ChrisChan114514/NUEDCTraining-2020E-DistortionWaveform-THDmeasure/2020年参考方案.pdf

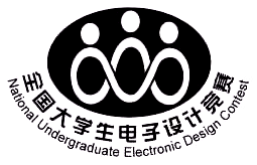
[picture p3: figure]

# 2020 年“TI 杯”第八届浙江省

# 大学生电子设计竞赛

# 设计报告

竞赛题号： | E

## 竞赛题目： 放大器非线性失真研究装置

参赛学生： | 钟沁轩 顾程鑫 李伟
参赛学校： | 杭州电子科技大学

2020 年 10 月

摘要

本作品完成了一个可以产生失真波形的放大器非线性失真研究装置，同时具

有测定波形谐波电压值与近似总失真系数的功能。作品以 STM32 单片机和 FPGA

为主控制器，STM32 控制 AD9959 DDS 模块，产生频率 1KHz、峰峰值 20mV 稳

定正弦波，并控制一个多路继电器，使三极管放大电路输出五种失真波形。波形

先经过以 OPA188 为主的信号调理电路，由 STM32 控制模块进行信号跟随或信

号放大。再送入 ADS8505 模块对信号进行模数转换。FPGA 先对采样倒的波形

数据缓存，再通过并行传输送入 STM32。STM32 对接受到的波形数据进行 FFT，

获得信号频谱数据，读取各个谐波分量电压值并进行总谐波失真系数计算。最后

将各个谐波分量电压值、总谐波失真系数、电压波形与数字频谱图进行屏幕打印。

关键词：放大器非线性失真分析；幅频特性；FFT；FPGA

1

## 一、方案比较（论证）

1、采集测量与微处理器方案比较与论证

方案一：使用 STM32F407 内置 ADC 采集晶体管放大器输出信号，并选择

STM32F407 作为微处理器，进行 FFT 处理获取谐波分量。这种方案的优点是系

统构成简单，所需硬件资源较少，但 STM32F407 的内置 ADC 只能测量 0V~3.3V

的输入电压，并且只有 12 位精度，无法保证精确测量，对信号 FFT 处理的影响

较大。同时，FFT 要求采样频率为 2 的指数，STM32 无法保证稳定精确的采样

频率，这也会影响 FFT 的结果，最终影响总谐波失真的准确测量。

方案二：通过 ADS8505 采集晶体管放大器输出信号，并使用 FPGA 缓存数

据。STM32 与 FPGA 进行并行传输获取缓存数据，计算 FFT 获取谐波分量。

ADS8505 的电压测量范围为-10V~+10V，具有 250KHz 采样率，精度高达 16 位。

通过 FPGA 设置精确时钟，可保证采样频率。同时，FPGA 与 STM32 的并行传

输，确保数据快速准确传输至 STM32F407 并进行 FFT 处理。此方案可以提高输

入电压范围，大大提高输入信号 FFT 的精确度。

综上所述，本系统采用方案二。
2、共射放大器级联方案比较与论证

方案一：采用单级共射放大器。根据理论计算及仿真分析，若采用 S9013H 三

极管，负载为100KΩ时的电压增益约为120V/V，可满足题目对于增益的要求，

但因无法使三极管同时工作在饱和区、截止区而产生双向失真，并且在后级功率

放大器产生交越失真时，由于增益过低也无法满足题目的输出幅值要求。

方案二：采用两级共射放大器级联。若采用两级阻容耦合共射放大器，可通

过控制第一级放大器增益产生一个大信号使第二级三极管产生双向失真，也可以

轻松控制整个放大器的电压增益，使输出幅值达到题目要求。

综上所述，本系统采用方案二。
3、AB 类功率放大器克服交越失真方案比较与论证

方案一：使用电阻压降产生偏置电压，使功率放大管处于微导通的状态，可

以有效的克服交越失真，虽然电路简单，但是电阻压降产生的偏置电压不稳定可

能会造成功率放大器的总谐波失真变大。

2

方案二：使用Vbe扩大电路产生偏置电压。Vbe扩大电路可以通过改变偏置电

阻的比值，从而改变功率放大管的偏压值，但电路结构较为复杂。

方案三：使用二极管压降产生偏置电压不但有着和电阻压降偏置同样简单的

电路，而且偏置电压较为稳定，且由于二极管的正向导通特性，无需复杂的设计

即可产生足够的偏置电压。

综上所述，本系统采用方案三。
4、ADC 信号调理方案比较与论证

方案一：仅使用运放跟随器。使用一颗精密运放进行跟随可以实现阻抗变换，

减小后级对前级电路的影响，但是测量20mVpp的输入信号时，由于信号幅值过于

微小，ADS8505 无法准确转换。

方案二：使用程控增益放大器。程控增益放大器可以轻松改变放大器增益，

但电路较为复杂且多数为高频电路设计，低频性能不佳，若要用于本题则需要重

新计算有关参数。

方案三：使用继电器切换同相放大器。使用继电器切换由运放组成的同相放

大电路，不仅可以实现阻抗变换的功能，而且可以在测量微小信号时使其放大一

定倍数，使 ADS8505 能够准确转换。

综上所述，本系统采用方案三。

## 二、理论分析与计算

1．共射放大电路静态工作点估算及交流电压放大倍数

共射放大电路如图 1 所示。在确定该电路静态工作点时，为保证 Q 点的稳

定，估算时选取：静态时
Rb2

流过的电流Ib = (5~10)IBQ,VBQ = (5~10)UBEQ。

计算公式如下：

VBQ ≈

Rb2

Rb1+Rb2

VCC | (1)

ICQ ≈

VBQ−UBEQ
Re

(2)

UCEQ = VCC − ICQ(RC + Re) | (3)

放大器交流放大倍数：

3

AV = −

β(RL//RC)

rbe

(4)

其中，
be r

为三极管输入电阻。其值为rbe = rbb′ + (1 + β)

UQ

IEQ

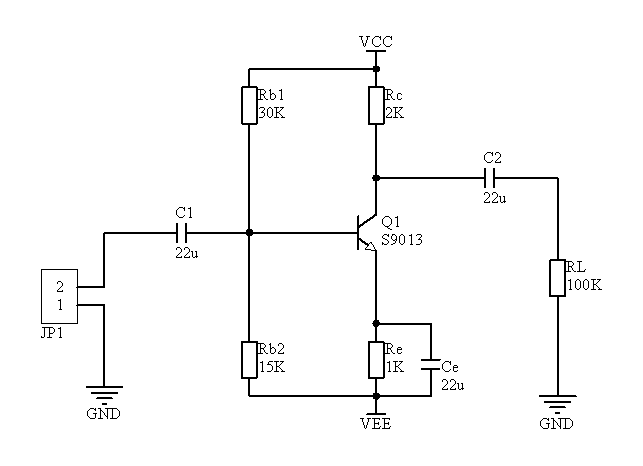
[picture p4: figure]

图 1 分压偏置式共射放大电路

其中，VCC=5V，VEE=-5V，β取 200，ICQ取 1.8mA，UBEQ取 0.64V，则VBQ=-

2.5V，IBQ=8.85μA，令Rb2=15KΩ，则Rb1≈43KΩ；令Re=1KΩ，则Rc ≈ 2KΩ。计

算Av ≈ 129V/V。实验发现有轻微削顶失真，故减小 Rb1 至30KΩ。 2．失真波形理论分析

1）顶部失真：三极管静态工作点过高，静态工作电流过小，管子进入截止区，

产生截止失真。

2）底部失真：三极管静态工作点过低，静态工作电流过大，管子进入饱和区，

产生饱和失真。

3）双向失真：放大器的输入信号幅值过高，导致信号正半周时管子进入截止

区，产生截止失真；信号负半周时管子进入饱和区，产生饱和失真，这两种失真

叠加就产生了双向失真。

4）交越失真：推挽式输出通常使用 NPN 型管和 PNP 型管，两管的基级和

发射极相互连接在一起，连接负载电阻。当有信号输入时，两个管子轮流导通。

若输入信号低于两管导通电压，两管都截止，负载上无电流通过，因此出现一段

死区，即交越失真。

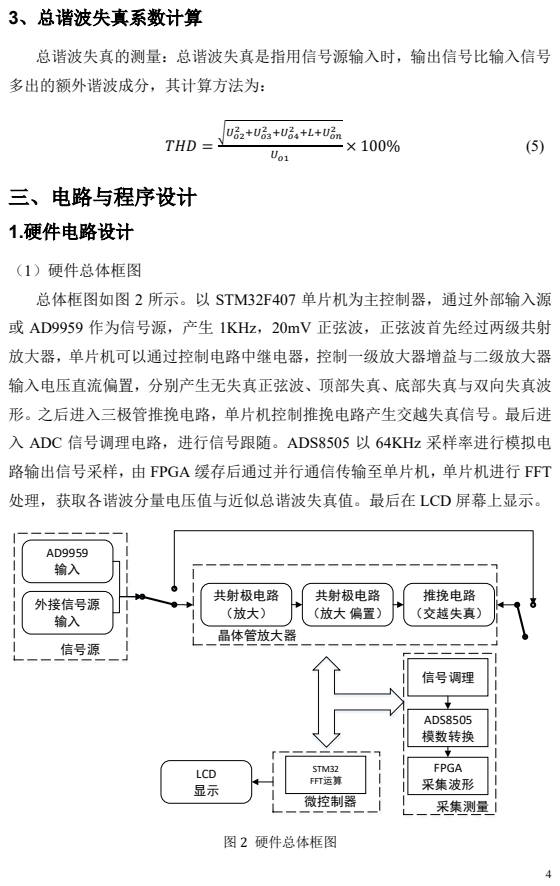
[picture p5: page 6]
3、总谐波失真系数计算; THD =; 2 +L+Uon; 三、电路与程序设计; 1.硬件电路设计; 信号调理; ADS8505 模数转换; STM32 FFT运算; 外接信号源 输入; LCD 显示; FPGA 采集波形; 微控制器; 采集测量; 信号源; 推挽电路 （交越失真）; 共射极电路 （放大 偏置）; 共射极电路 （放大）; 晶体管放大器; 图 2 硬件总体框图

总谐波失真的测量：总谐波失真是指用信号源输入时，输出信号比输入信号
多出的额外谐波成分，其计算方法为：

（1）硬件总体框图
总体框图如图 2 所示。以 STM32F407 单片机为主控制器，通过外部输入源
或 AD9959 作为信号源，产生 1KHz，20mV 正弦波，正弦波首先经过两级共射
放大器，单片机可以通过控制电路中继电器，控制一级放大器增益与二级放大器
输入电压直流偏置，分别产生无失真正弦波、顶部失真、底部失真与双向失真波
形。之后进入三极管推挽电路，单片机控制推挽电路产生交越失真信号。最后进
入 ADC 信号调理电路，进行信号跟随。ADS8505 以 64KHz 采样率进行模拟电
路输出信号采样，由 FPGA 缓存后通过并行通信传输至单片机，单片机进行 FFT
处理，获取各谐波分量电压值与近似总谐波失真值。最后在 LCD 屏幕上显示。

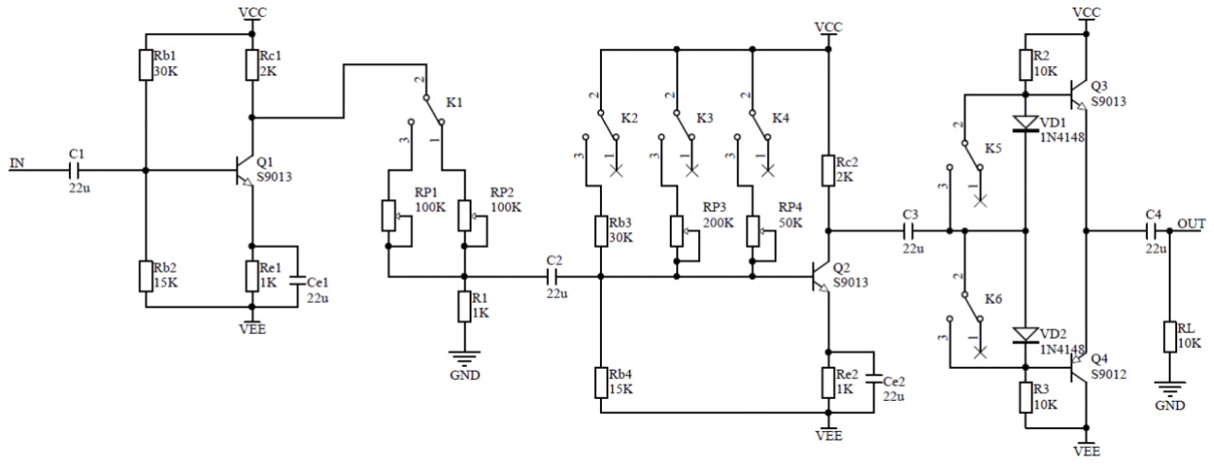
[picture p6: figure]

5

（2）程控放大器电路

本电路由两级三极管共射放大器和一级 AB 类三极管功率放大器组成，通过

继电器切换电阻和短路偏置二极管的方式，实现了程控产生四种失真波形的功能。

（如图 3 所示）

1）正常情况：继电器 K1，K3 吸合，其余继电器释放，Rp1 分压减小第二级

输入幅值，第二级放大不会发生失真，基极偏置电阻 Rb1，Rb2，Rb3，Rb4 为两

个晶体管提供正常偏置，后级功放管也处于微导通状态，无交越失真，电路正常

工作。

2)顶部失真：继电器 K2，K4 吸合，其余继电器释放， Rp2 阻值较小，使输

入第二级共射放大器的信号幅值增大，同时 Rp3 调整至比 Rb4 大的某一阻值，

使第二级放大器工作在截止区，波形出现顶部失真。

3)底部失真：继电器 K1，K5 吸合，其余继电器释放，其中 Rp4 调整至比 Rb4

小的某一阻值，使第二级放大器工作在饱和区，波形出现底部失真。

4)双向失真：继电器 K2，K3 吸合，其余继电器释放，其中 Rp2 调整成较小

阻值，使输入第二级共射放大器的信号幅值增大，使第二级放大器工作在饱和区，

截止区而产生双向失真。

5)交越失真：继电器 K1，K6，K7 吸合，其余继电器释放，前两级共射放大

器正常工作，末级功放由于二极管被短路，功放管失去直流偏置，信号低于管子

导通电压时管子无法导通，产生交越失真。

图 3 程控放大器电路原理图

6

(3)电源方案设计

系统电源方案分为模拟电源与数字电源两部分，模拟电源采用线性稳压器

78XX、79XX 系列，为系统内放大器电路与信号调理电路供电。数字电源采用开

关电源 TPS5430 系列，为系统内 STM32 与 FPGA 供电。
2.程序设计

STM32 控制 ADS9959 输出 1KHZ、20mVpp 的正弦波作为输入信号；FPGA

控制 ADS8505 以 64KSPS 速率采样，将得到的 ADC 数据存入内部的 RAM 中。

当 STM32 通过并口传输协议向 FPGA 发送数据请求时，FPGA 发送 ADC 采集到

256 个电压值发送给 STM32。STM32 根据得到的数据进行点数为 256 的 FFT 变

换，得到各个谐波分量的频谱信息，经过计算得到“总谐波失真”的近似值，最终

将得到的结果显示在 LCD 上。软件系统流程图如图 4 所示，“总谐波失真”的近

似值计算流程图如图 5 所示。

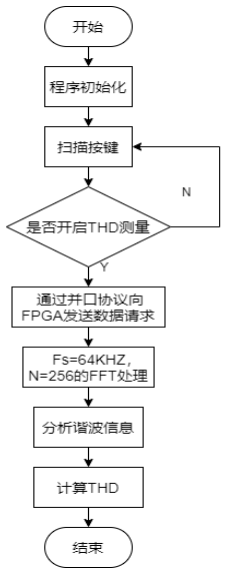
[picture p7: figure]
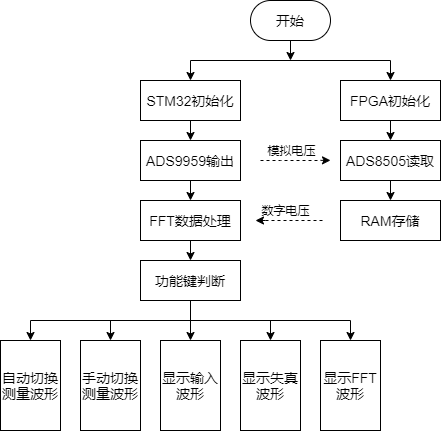
[picture p8: figure]

图 4 软件系统流程图 | 图 5 “总谐波失真”的近似值计算流程图

## 四、测试方案与测试结果

1、系统测试方案

采用外接信号源，通过硬件电路产生无失真或各种失真类型正弦波。用

7

ADS8505 采样输出电压，通过并行通信将数据传递至 STM32，STM32 进行 FFT

计算得到幅频特性曲线，并获取各谐波电压幅值，计算总谐波失真。

表 1 测试仪器列表

序号 | 仪器类别 | 仪器型号 | 数量 | 性能参数
1 | 信号源 | DG822 | 1 | 10HZ-35MHZ
2 | 示波器 | MSO5102 | 1 | 500Mhz
3 | 学生电源 | DP832 | 1 | 30V/3A*2
4 | 功率分析仪 | PA6000H | 1 | 可测量总谐波失真
2、测试结果与分析

（1）三极管放大器电路输出波形测试。

输入信号为 20mVpp，1KHz 正弦信号，测量输出电压波形，与电压波形幅值。

（无失真及各种失真波形图片见附录图片 6、7、8、9、10、11）

表 2 各失真波形峰峰值电压
波形种类 | 峰峰值电压
无明显失真电压波形 | 3.120V
顶部失真电压波形 | 4.736V
底部失真电压波形 | 2.908V
双向失真电压波形 | 6.232V
小交越失真电压波形 | 2.654V
大交越失真电压波形 | 2.512V
根据实验数据，放大器电路各类失真输出波形符合题目要求，输出电压峰峰

值都达到了 2V 以上，完全满足题目要求。
（2）采集测量模块 THD 误差测量。

输入信号为 20mVpp，1KHz 正弦信号，通过三极管放大电路输出各类失真波

形，与功率分析仪 PA6000H 测量 THD 值对照。结果如表 3 所示。

表 3 各失真波形 THD 值测试

输出波类型 | 功率分析仪 THD 值 | 实际测量 THD 值 | 误差
无明显失真正弦波 | 4.761% | 4.804% | 0.903%
顶部失真正弦波 | 60.941% | 61.325% | 0.630%

8

根据实验数据，采集测量模块测量 THD 值与实验仪器测量 THD 值误差保持

在 3%以内，有着比较高的采集测量精度。

## 五、总结

本作品设计了一个放大器非线性失真研究装置，实现了信号发生，波形放大、

程控输出多种失真波形与测量信号近似总谐波失真数值的功能。为了实现波形放

大与输出 5 种失真波形，必须准确计算放大电路电压增益与偏置电压，设计放大

器电路参数。与此同时，我们使用 FPGA 稳定的时钟晶振保证采样频率为 0.25kHz

的倍数，加快了采样速率，提高了 FFT 计算精度，保证了计算各谐波电压值的准

确性。

底部失真正弦波 | 14.751% | 14.702% | -0.332%
双向失真正弦波 | 24.785% | 25.187% | 1.621%
小交越失真正弦波 | 10.743% | 10.468% | -2.560%
大交越失真正弦波 | 22.536% | 22.500% | -0.160%
标准方波 | 38.889% | 39.050% | 0.414%
标准三角波 | 11.782% | 11．781% | -0.009%

9

附录

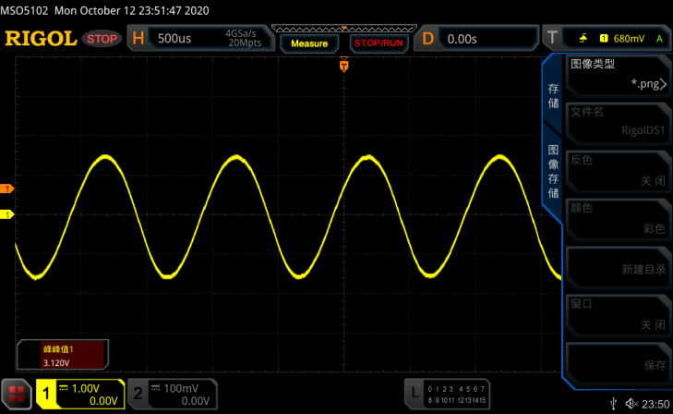
[picture p9: figure]

图 6 无失真正弦波

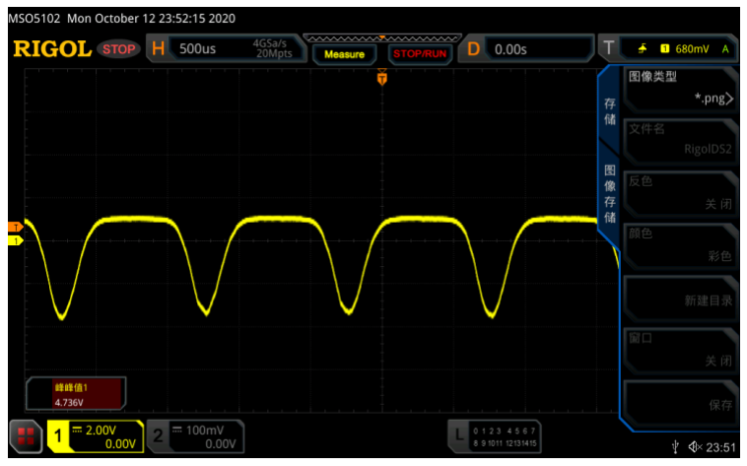
[picture p10: figure]

图 7 顶部失真

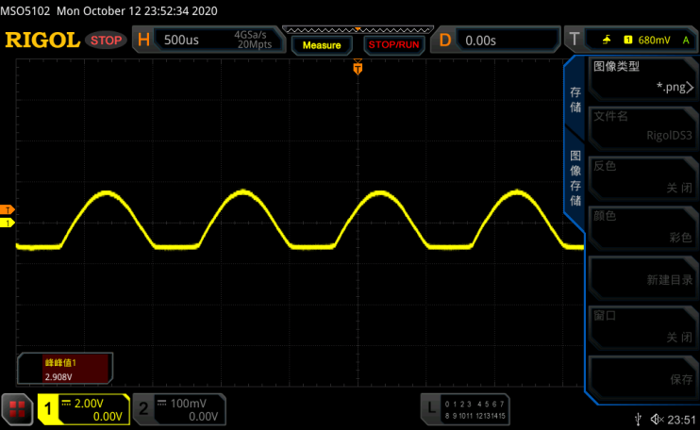
[picture p11: figure]

图 8 底部失真

10

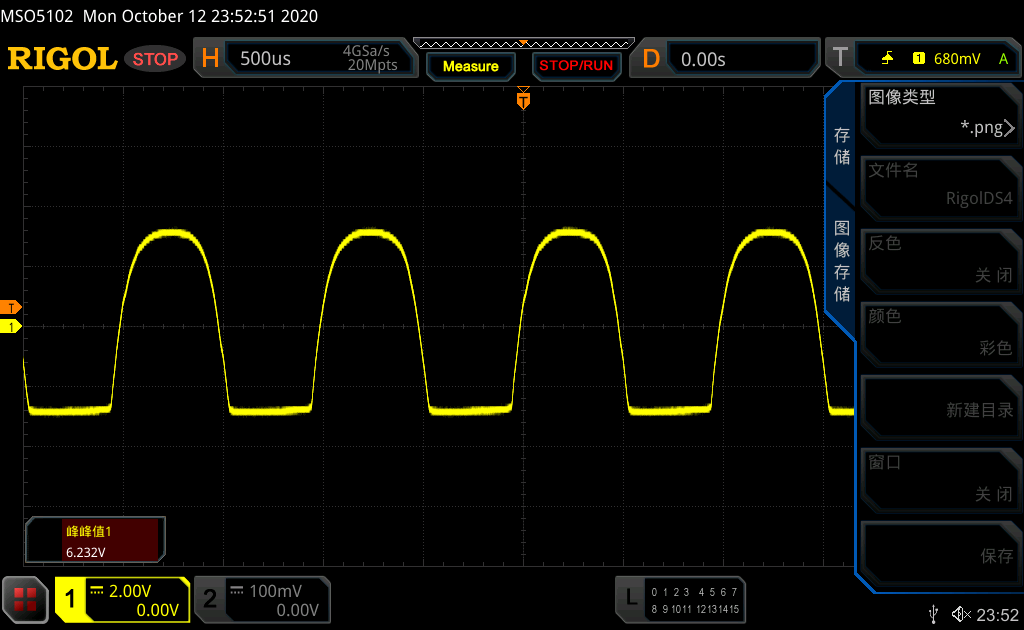
[picture p12: figure]

图 9 双向失真

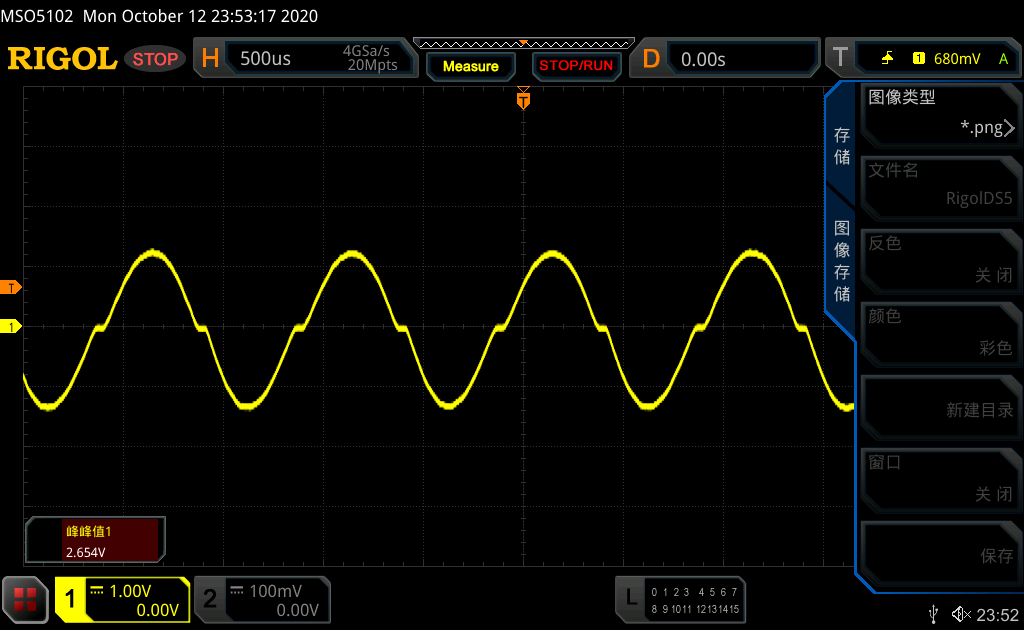
[picture p13: figure]

图 10 小交越失真

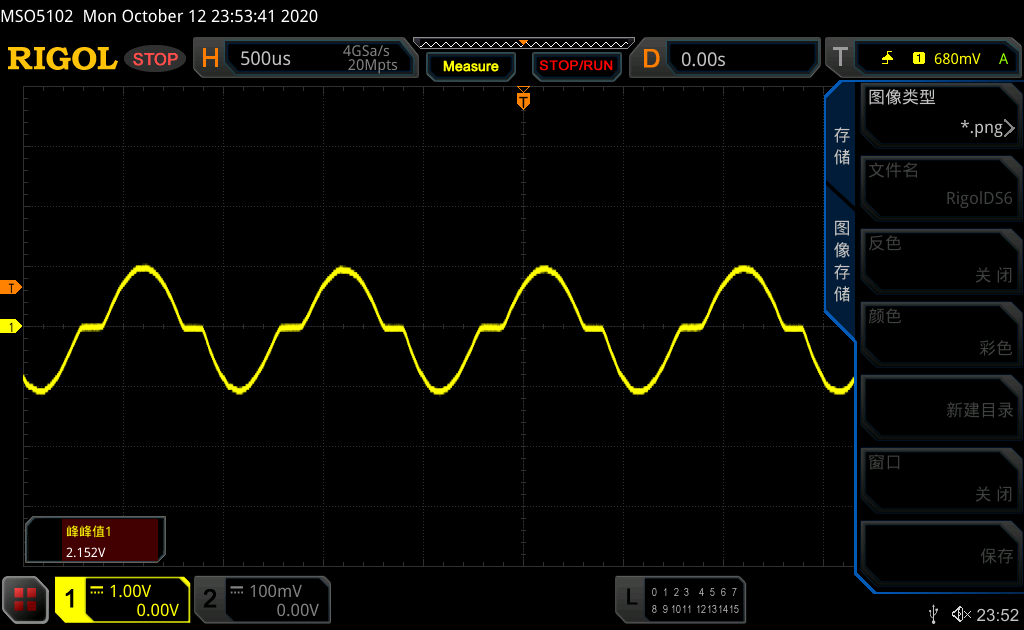
[picture p14: figure]

图 11 大交越失真

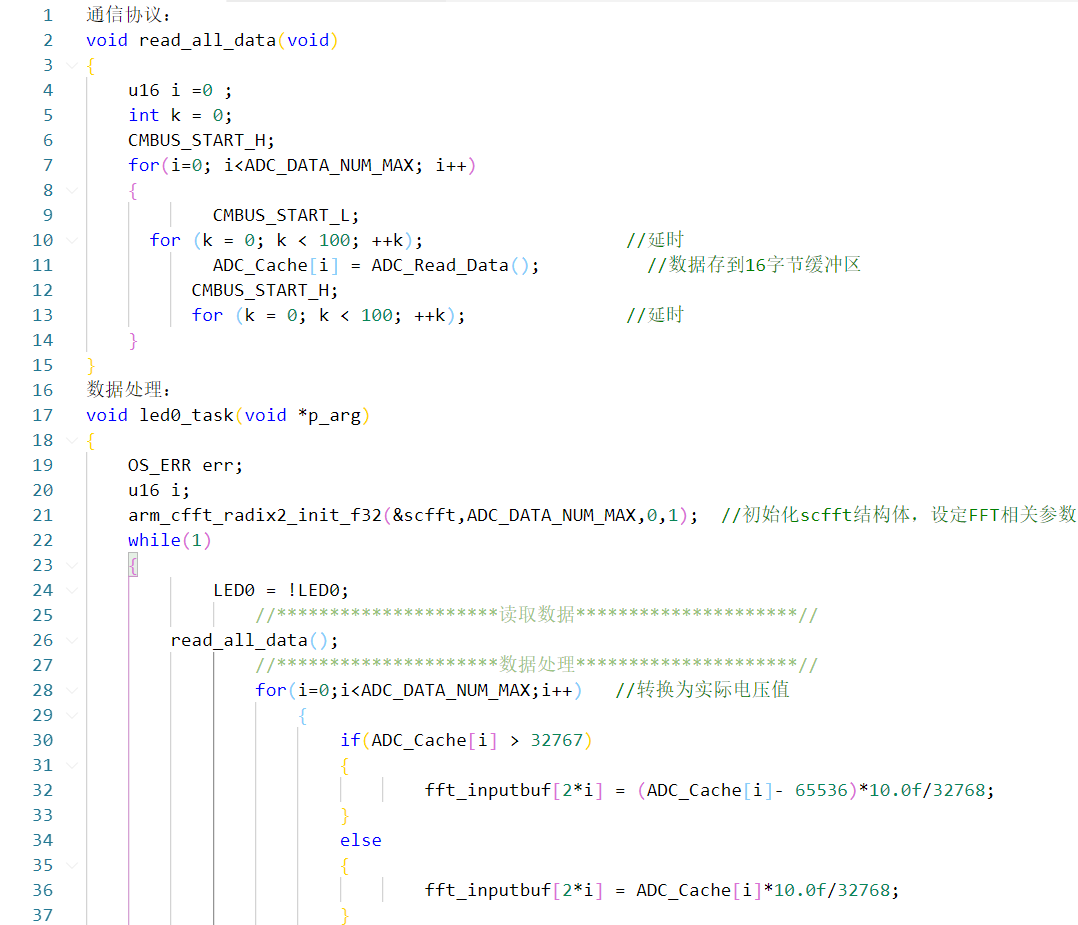
[picture p15: figure]

11

图 12 STM32 代码

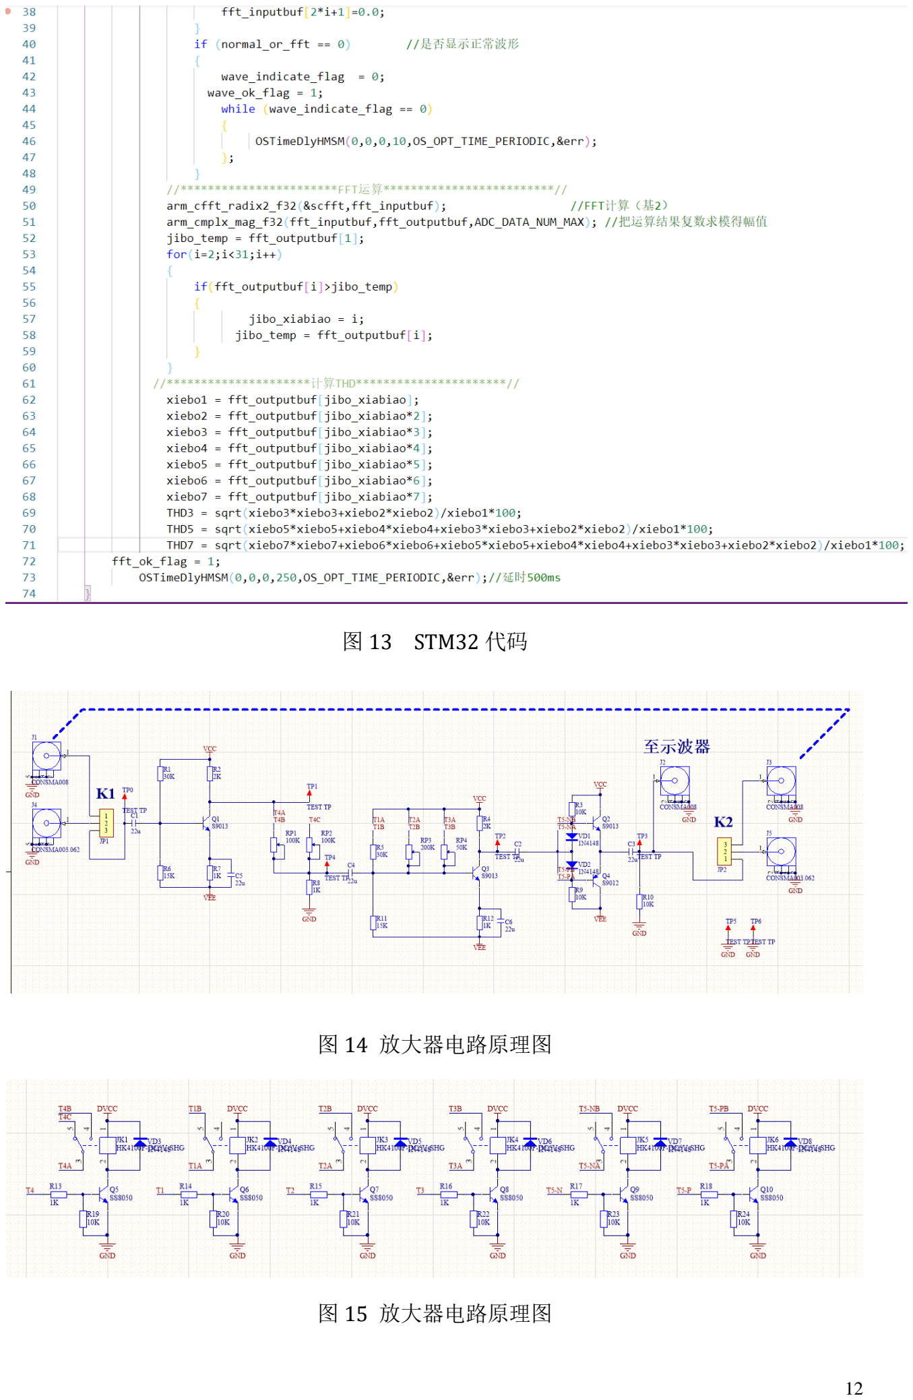
[picture p16: page 14]

12

图 13 STM32 代码

图 14 放大器电路原理图

图 15 放大器电路原理图

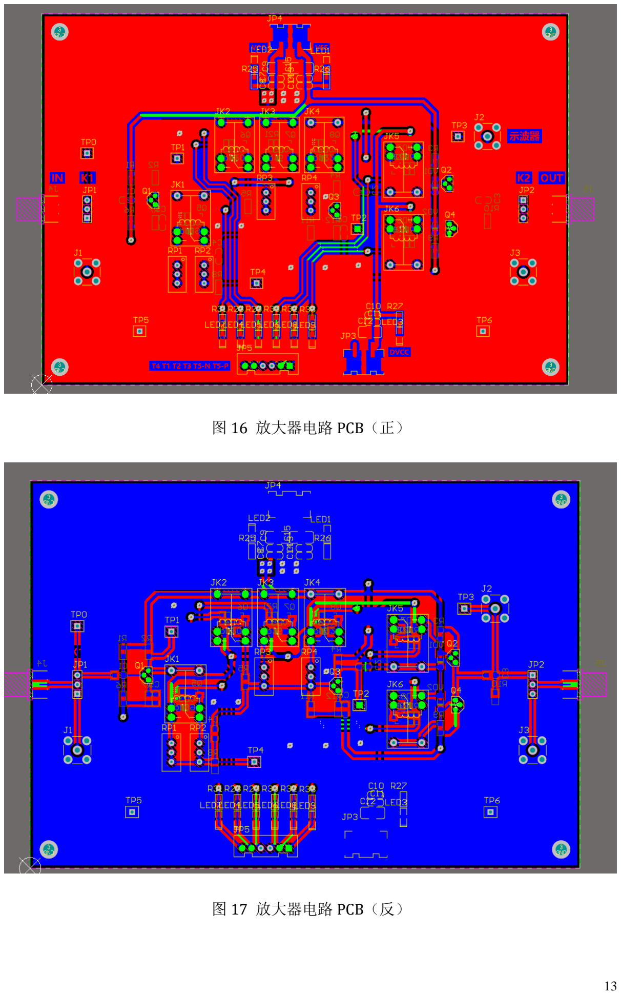
[picture p17: page 15]

13

图 16 放大器电路 PCB（正）

图 17 放大器电路 PCB（反）

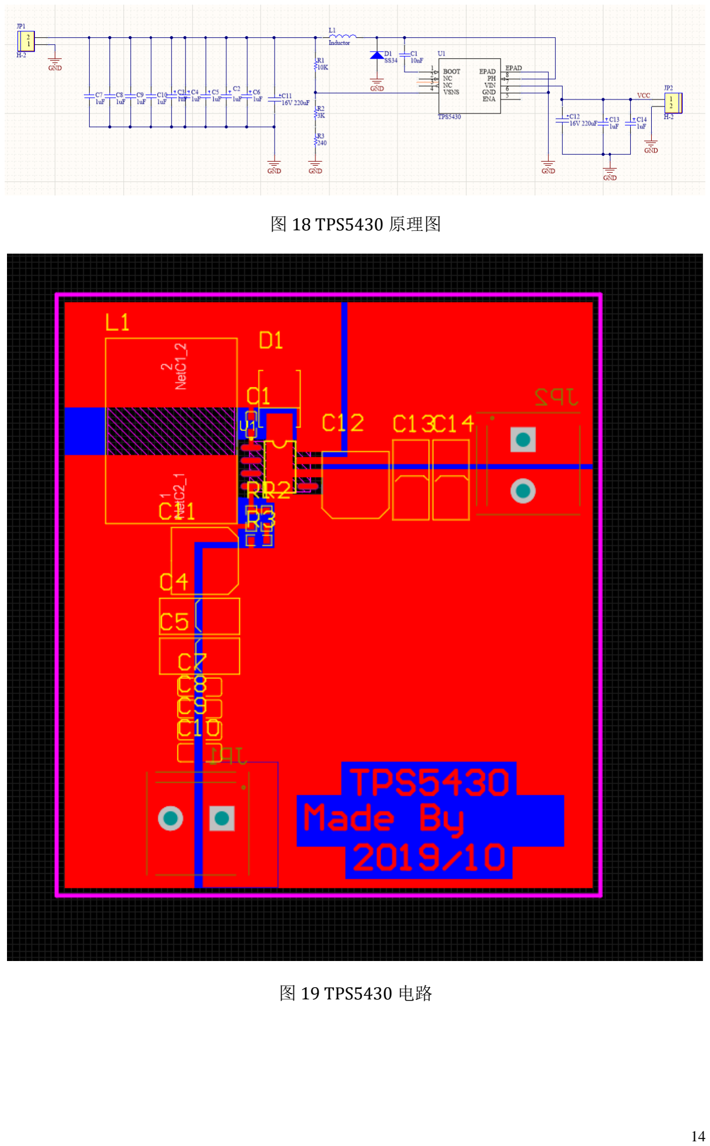
[picture p18: page 16]

14

图 18 TPS5430 原理图

图 19 TPS5430 电路

15

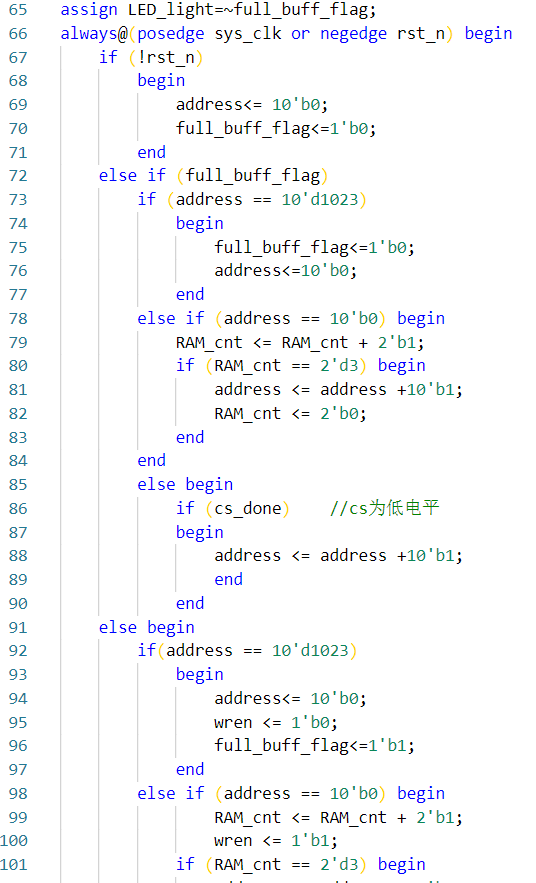
[picture p19: figure]

图 20 FPGA 代码

16

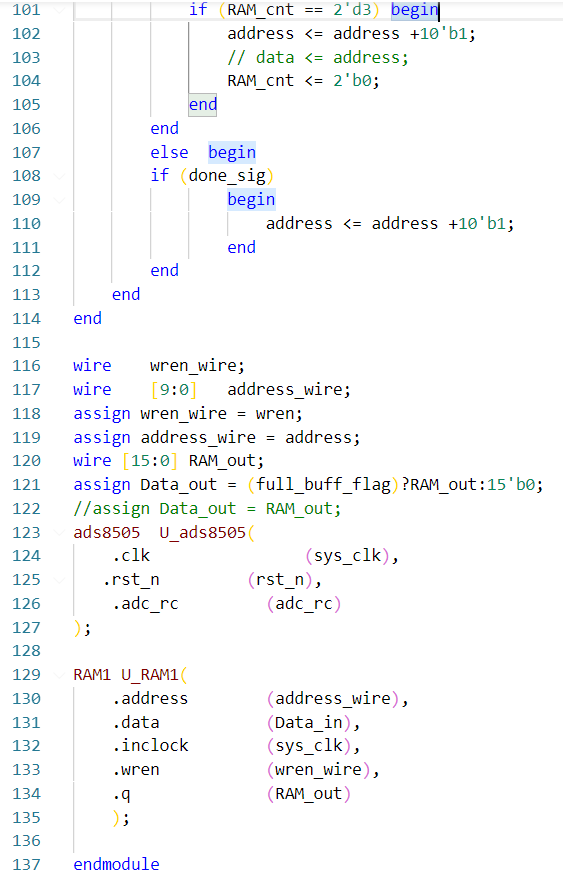
[picture p20: figure]

图 21 FPGA 代码
