ChrisChan114514/NUEDCTraining-2020E-DistortionWaveform-THDmeasure/硬件照片/微信图片_20250122113851.jpg

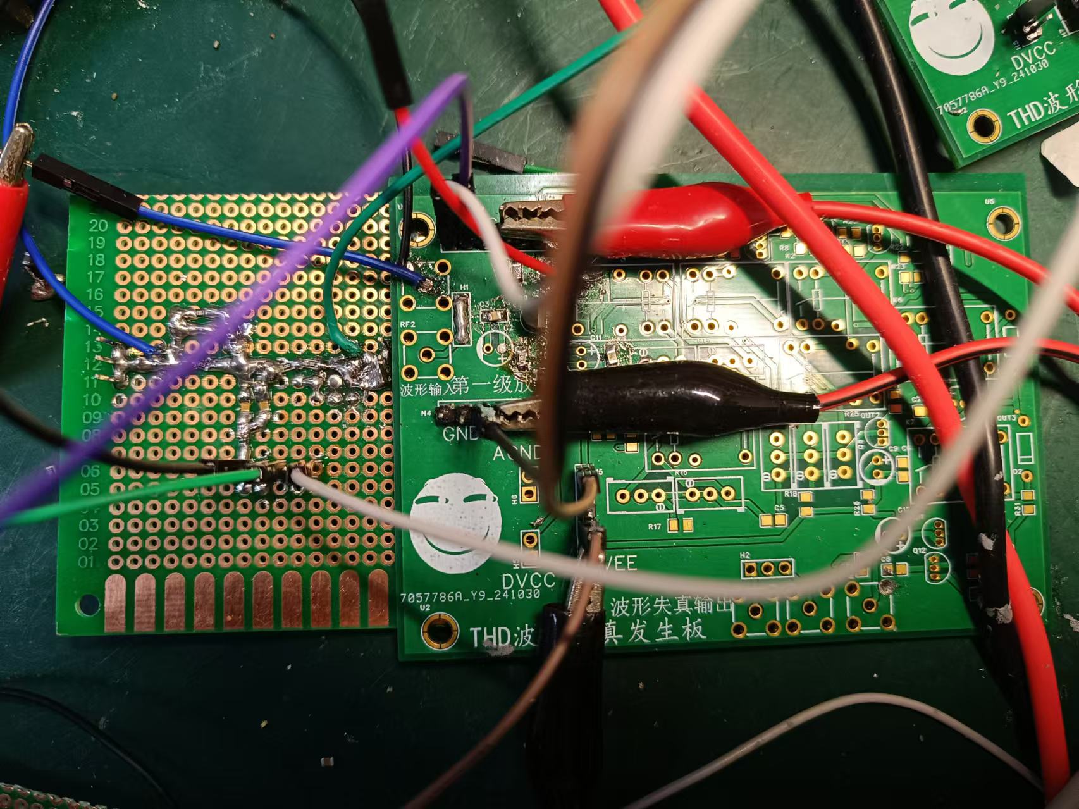
硬件照片/微信图片_20250122113851.jpg
