ChrisChan114514/NUEDCTraining-2020E-DistortionWaveform-THDmeasure/硬件照片/微信图片_202501221138512.jpg

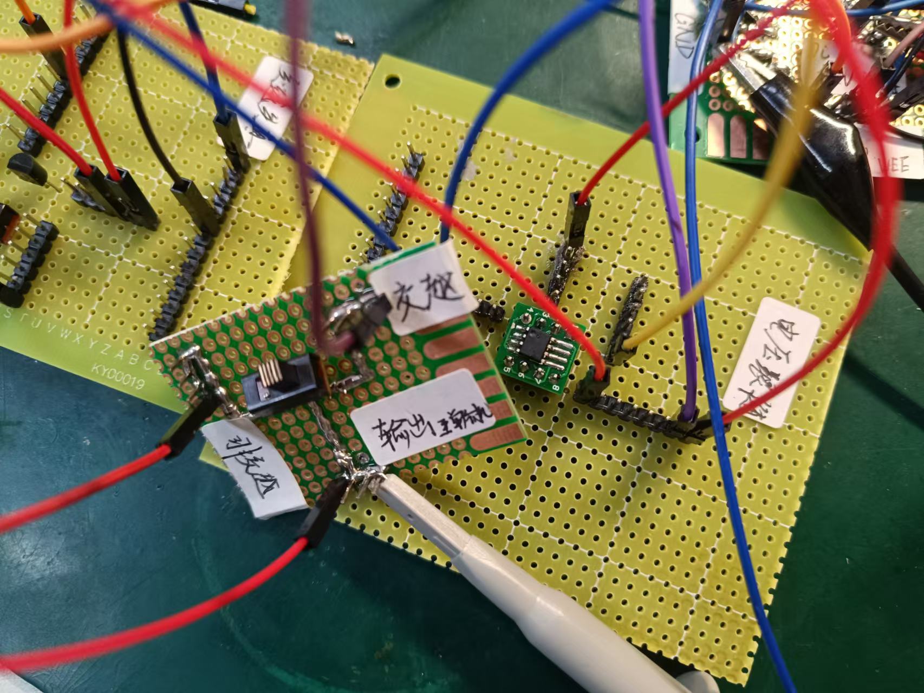
硬件照片/微信图片_202501221138512.jpg
