ChrisChan114514/NUEDCTraining-2020E-DistortionWaveform-THDmeasure/(list of files, drawings)

Other design files:
Mulitism验证/交越失真.ms14
Mulitism验证/单管放大.ms14
Mulitism验证/双向大摆幅失真THD .ms14
Mulitism验证/底端饱和失真.ms14
Mulitism验证/正常放大THD (2).ms14
Mulitism验证/顶端截止失真THD.ms14
