ChrisChan114514/NUEDCTraining-2020E-DistortionWaveform-THDmeasure/SUM/Core/Src/main.c

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
/* Includes ------------------------------------------------------------------*/
#include "main.h"
#include "adc.h"
#include "dac.h"
#include "dma.h"
#include "i2c.h"
#include "spi.h"
#include "tim.h"
#include "usart.h"
#include "gpio.h"
#include "fsmc.h"

/* USER CODE BEGIN Includes */
#include "stdio.h"
#include "lcd.h"
#include "arm_math.h"
#include "arm_const_structs.h"
#include "LCD_Show.h"
#include "fft_handle.h"
#include "TFTGPIO.h"

/* USER CODE END Includes */

/* USER CODE BEGIN PD */
#define FFT_LENGTH 4096										//采样点个数

/* USER CODE END PD */


/* USER CODE BEGIN PV */
uint16_t i = 0;
uint16_t j = 0;
uint16_t DrawingTime_cnt = 0;
uint16_t PWMCheck_cnt = 0;					
uint16_t adcBuff[FFT_LENGTH];							//adc采样数组
float adcVolt[FFT_LENGTH];								//adc转换后的真实电压数组
__IO uint8_t AdcConvEnd = 0;							//adc采集完成标志
uint32_t f_sa = 25600;										//基础采样频率为17.3k  
float fft_frequency = 0;
float fft_frequency2=0;   //FFT测出最大基波频率、次大基波频率
extern float fft_outputbuf[FFT_LENGTH];  				//fft计算后数组
extern float bizhi1[10];

/* USER CODE END PV */

void SystemClock_Config(void);
/* USER CODE BEGIN 0 */

float PWM_RisingCount;
float PWM_FallingCount;
float duty;
char P_buff[30];
float PWM_frequency = 0;
//************************THD题目变量*********************
int key_flag=0;
int mode=0;

int key_index=0;
//********************************************************

//void HAL_GPIO_EXIT_Callback(uint16_t GPIO_PIN)
//{
//	if (GPIO_PIN==GPIO_PIN_4)
//	{
//		key_flag=1;
//		HAL_GPIO_TogglePin(GPIOF,GPIO_PIN_10);
//	}
//	else if (GPIO_PIN==GPIO_PIN_3)
//	{
//		HAL_GPIO_TogglePin(GPIOF,GPIO_PIN_10);
//	}
//}

void PWM_Input_Capture(void)
{
//		printf("PWM_Frequency = %.4f \r\n",1000000/PWM_RisingCount);			//数据测试
//		printf("PWM_RisingCount = %.2f %% \r\n",PWM_RisingCount);
//		printf("PWM_FallingCount = %.2f %% \r\n",PWM_FallingCount);
//	  printf("PWM_Duty = %.2f %% \r\n",duty * 100);
		PWMCheck_cnt++;
		if (PWMCheck_cnt==10)
		{
			lcd_show_string(405,160,80,16,16,"PWM_F(Hz):",YELLOW);
			sprintf(P_buff,"%0.3fHz",1000000/PWM_RisingCount);									//PWM测频率
			lcd_show_string(405,180,130,16,16,P_buff,WHITE);			
			lcd_show_string(405,120,80,16,16,"Duty:",YELLOW);	
			sprintf(P_buff,"%.2f %%",duty * 100);																//PWM测占空比
			lcd_show_string(405,140,80,16,16,P_buff,WHITE);
			PWMCheck_cnt = 0;
		}
		
}
/* USER CODE END 0 */

/**
  * @brief  The application entry point.
  * @retval int
  */
int main(void)
{

  /* MCU Configuration--------------------------------------------------------*/

  /* Reset of all peripherals, Initializes the Flash interface and the Systick. */
  HAL_Init();

  /* Configure the system clock */
  SystemClock_Config();

  /* Initialize all configured peripherals */
  MX_GPIO_Init();
  MX_DMA_Init();
  MX_ADC1_Init();
  MX_USART1_UART_Init();
  MX_TIM3_Init();
  MX_TIM2_Init();
  MX_FSMC_Init();
  MX_SPI1_Init();
  MX_SPI2_Init();
  MX_DAC_Init();
  MX_I2C1_Init();
  MX_TIM4_Init();
  MX_TIM5_Init();
  /* USER CODE BEGIN 2 */
	lcd_init();
	lcd_display_dir(1);
	HAL_TIM_Base_Start(&htim2);											
  //HAL_TIM_PWM_Start(&htim2, TIM_CHANNEL_2);
	HAL_TIM_Base_Start(&htim3);//启动定时器3
	HAL_TIM_IC_Start_IT(&htim3,TIM_CHANNEL_1);							//定时器3通道1——上升沿捕获
	HAL_TIM_IC_Start_IT(&htim3,TIM_CHANNEL_2);							//定时器3通道2——下降沿捕获
	Set_BackGround();	        //显示背景
	Lcd_DrawNetwork();
	Draw_Prompt();				//画提示符
	
	HAL_ADC_Start_DMA(&hadc1,(uint32_t*)adcBuff,FFT_LENGTH);//启动ADC的DMA传输

	TFTGPIO_main(0);

  /* USER CODE END 2 */

  /* Infinite loop */
  /* USER CODE BEGIN WHILE */
  while (1)
  {
	
	//***************THD逻辑*************************
	  key_index++;
		if (key_index==15)
		{
			key_index=0;
			if (HAL_GPIO_ReadPin(GPIOE,GPIO_PIN_4)==GPIO_PIN_RESET)
			{
				mode++;
				if (mode==5)
				{
					mode=0;
				}
			}
		}
	  
	  TFTGPIO_main(mode);
	  
	 //********************************************
	  
	  while (!AdcConvEnd);                                   //等待转换完毕
		for (j = 0; j < FFT_LENGTH; j++)										//输出adc模拟采样值
		{
			adcVolt[j] = adcBuff[j] * 3.3 / 4095;							// adcBuff[j]* 3.3 / 4096是为了将ADC采集到的值转换成实际电压


			//printf("adcBuff[%d]:%.3f\n",j,adcVolt[j]*1000); 			//数据打印，查看结果
		}
		//ADCvolt_ANA();
//		DrawingTime_cnt++;           //去掉波形显示
//		if (DrawingTime_cnt==10)
//		{
//			//DrawOscillogram();
//			DrawingTime_cnt = 0;
//		}
		//printf("checkmain\n");
		fftCalculate();
		
		HAL_ADC_Start_DMA(&hadc1,(uint32_t*)adcBuff,FFT_LENGTH);//启动ADC的DMA传输
		
		
    /* USER CODE END WHILE */

    /* USER CODE BEGIN 3 */
  }
	
  /* USER CODE END 3 */
}

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
/* USER CODE BEGIN 4 */

void HAL_TIM_IC_CaptureCallback(TIM_HandleTypeDef *htim)
{
	if(htim->Channel == HAL_TIM_ACTIVE_CHANNEL_1)    
    //注意这里为HAL_TIM_ACTIVE_CHANNEL_1而不是TIM_CHANNEL_1
	{
		PWM_RisingCount = HAL_TIM_ReadCapturedValue(&htim3,TIM_CHANNEL_1);
		duty =	PWM_FallingCount / PWM_RisingCount;
	}
	if(htim->Channel == HAL_TIM_ACTIVE_CHANNEL_2)
	{
		PWM_FallingCount = HAL_TIM_ReadCapturedValue(&htim3,TIM_CHANNEL_2);
	}
	PWM_Input_Capture();
}



//void HAL_ADC_ConvCpltCallback(ADC_HandleTypeDef* hadc)
//{
//    if(hadc==&hadc1 && i < FFT_LENGTH)
//    {
//				adcBuff[i] =HAL_ADC_GetValue(&hadc1);				//采样存入adcBuff[FFT_LENGTH]
//        i++;
//		}
//		else 
//		{
//			AdcConvEnd=1;																	//采样完成，标志置1，开始fft计算
//			i = 0;
//		}
//			
//}
/* USER CODE END 4 */
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
