ChrisChan114514/NUEDCTraining-2020E-DistortionWaveform-THDmeasure/(notices)

Notices in the files:
SUM/Core/Src/main.c:
Copyright (c) 2024 STMicroelectronics.
All rights reserved.
This software is licensed under terms that can be found in the LICENSE file
